kinoppyd/rubykansai09/cad/speed_sensor_case/dimensions.png

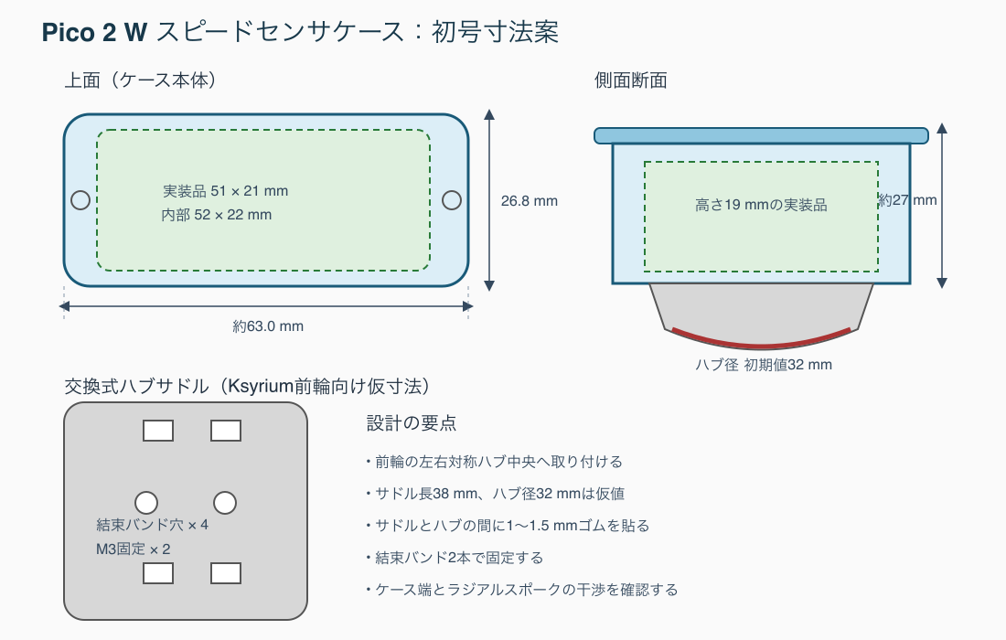
cad/speed_sensor_case/dimensions.png
