kinoppyd/rubykansai09/cad/speed_sensor_case/stl/speed_sensor_lid.stl

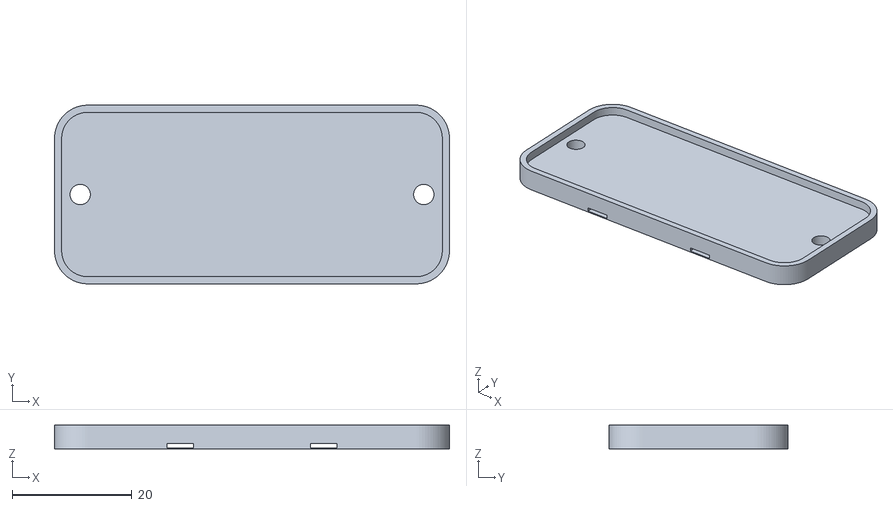
[picture p2: CAD file, 2026-07-17]
cad/speed_sensor_case/stl/speed_sensor_lid.stl
66.1 x 29.9 x 4.00
