kinoppyd/rubykansai09/cad/speed_sensor_case/stl/speed_sensor_gasket.stl

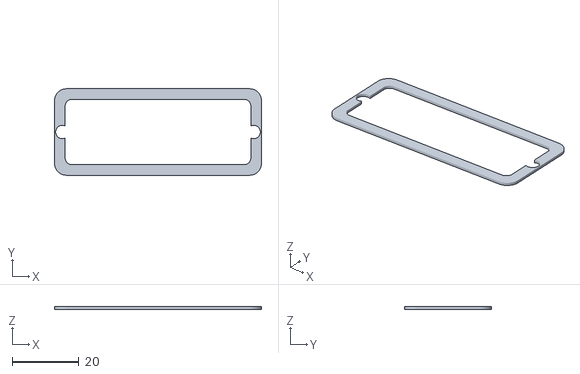
[picture p3: CAD file, 2026-07-17]
cad/speed_sensor_case/stl/speed_sensor_gasket.stl
62.2 x 26.0 x 0.8
