kinoppyd/rubykansai09/cad/speed_sensor_case/stl/speed_sensor_body.stl

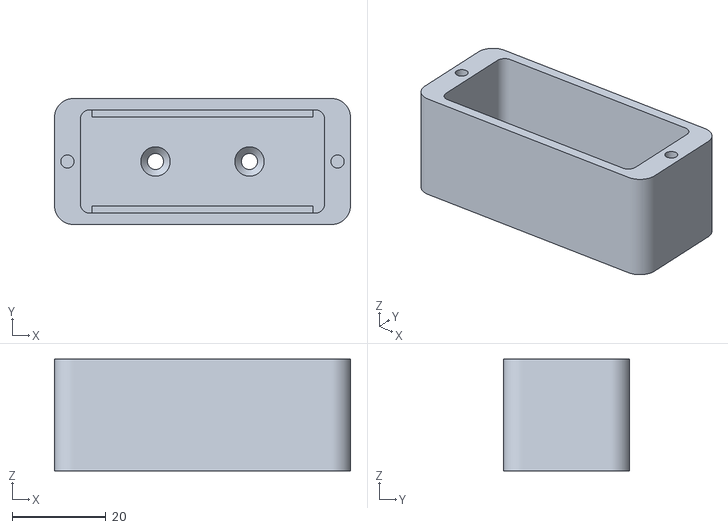
[picture p4: CAD file, 2026-07-17]
cad/speed_sensor_case/stl/speed_sensor_body.stl
63.0 x 26.8 x 23.8
