kinoppyd/rubykansai09/cad/speed_sensor_case/stl/speed_sensor_saddle.stl

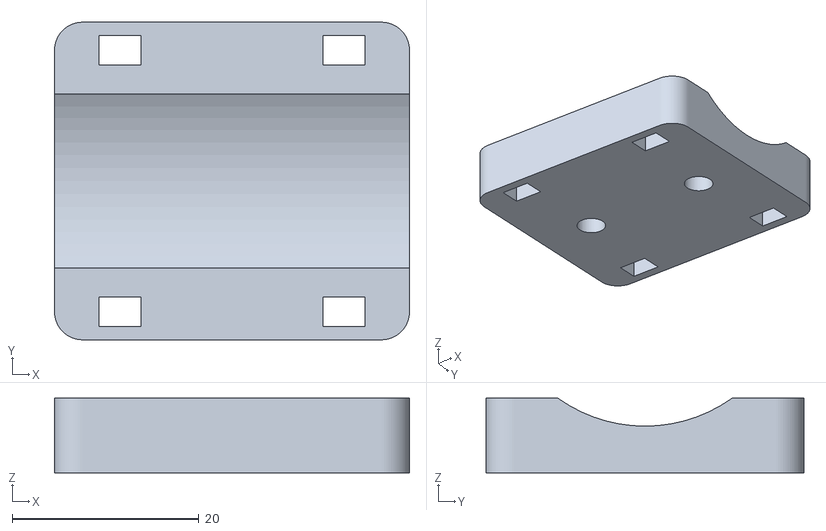
[picture p5: CAD file, 2026-07-17]
cad/speed_sensor_case/stl/speed_sensor_saddle.stl
38.0 x 34.0 x 8.00
