kinoppyd/rubykansai09/(commit log)

2026-06-21 Optimize PicoRuby sensor memory usage
2026-06-24 Use gyro integration for rotation detection
2026-06-28 Plan two-board BLE time demo
2026-07-09 Add BLE UART cycle demo apps
2026-07-09 Document BLE UART cycle demo verification
2026-07-09 Improve BLE UART central discovery logging
2026-07-09 Update BLE UART demo troubleshooting docs
2026-07-09 Queue BLE events for UART GATT discovery
2026-07-09 Treat BLE UART notifications as sensor ready
2026-07-09 Register BLE UART notification listener
2026-07-09 Mark BLE UART bring-up progress
2026-07-09 Mark MPU BLE sensor verification
2026-07-10 Lazy-load cycle display wire codec
2026-07-11 Keep cadence unavailable until sensor input exists
2026-07-11 Plan dedicated cadence sensor support
2026-07-11 Add MPU-6050 cadence sensor app
2026-07-11 Add two-slot BLE UART central
2026-07-11 Display dedicated cadence sensor data
2026-07-11 Track sensor notification timeouts independently
2026-07-11 Document cadence sensor validation and builds
2026-07-11 Diagnose multi-sensor advertising matches
2026-07-11 Add debug led
2026-07-11 Increase cycle sensor update rate
2026-07-12 Document current PicoRuby patches
2026-07-12 Add PicoRuby patch chain verification
2026-07-13 Replace legacy PicoRuby patch chain
